LabZDjee/waeco-cool-power-m50u/lvd.pdf

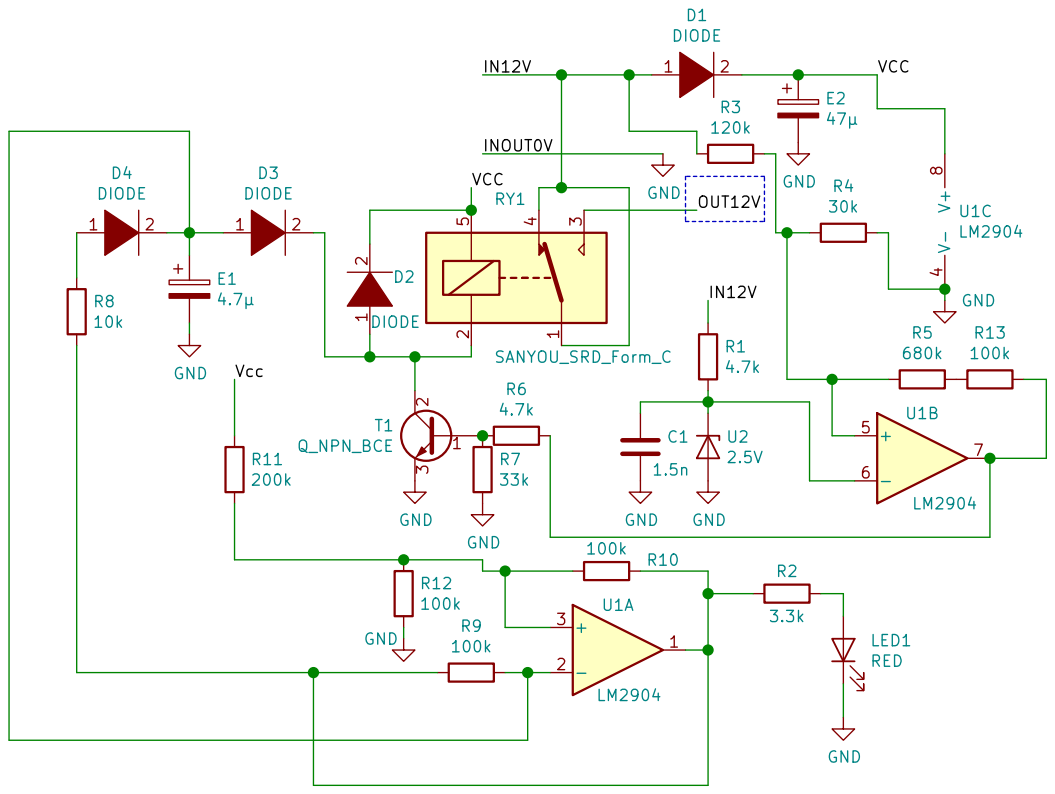
[picture p4: page 1]

cut-in 12.8V - cut-out 11.6 V
File: lvd.sch Sheet: / WAECO
