LabZDjee/waeco-cool-power-m50u/ltspice/led-flash.asc

D3: diode
D4: diode
E1: cap; 4.7µ
R8: res; 10k
R9: res; 100k
R10: res; 100k
R11: res; 200k
R12: res; 100k
U1: opamp2; LM2904
V1: voltage; 10V
Named nets: 0, LedDrive
.lib LM2904.cir
.tran 30
Period: 520 ms
Duty Cycle: 37 / 520 = 7%
If D3 connected, LED constantly on
