LabZDjee/waeco-cool-power-m50u/ltspice/compare.asc

D1: diode
R1: res; 470
R3: res; 120k
R4: res; 30k
R5: res; 350k
U1: opamp2; LM2904
V2: voltage; PWL(0 9 1 14 2 9)
VRef: voltage; 2.5V
Named nets: 0
.lib LM2904.cir
.tran 3
