LabZDjee/waeco-cool-power-m50u/lvd.sch

## KiCad design lvd.sch (2019-08-04)

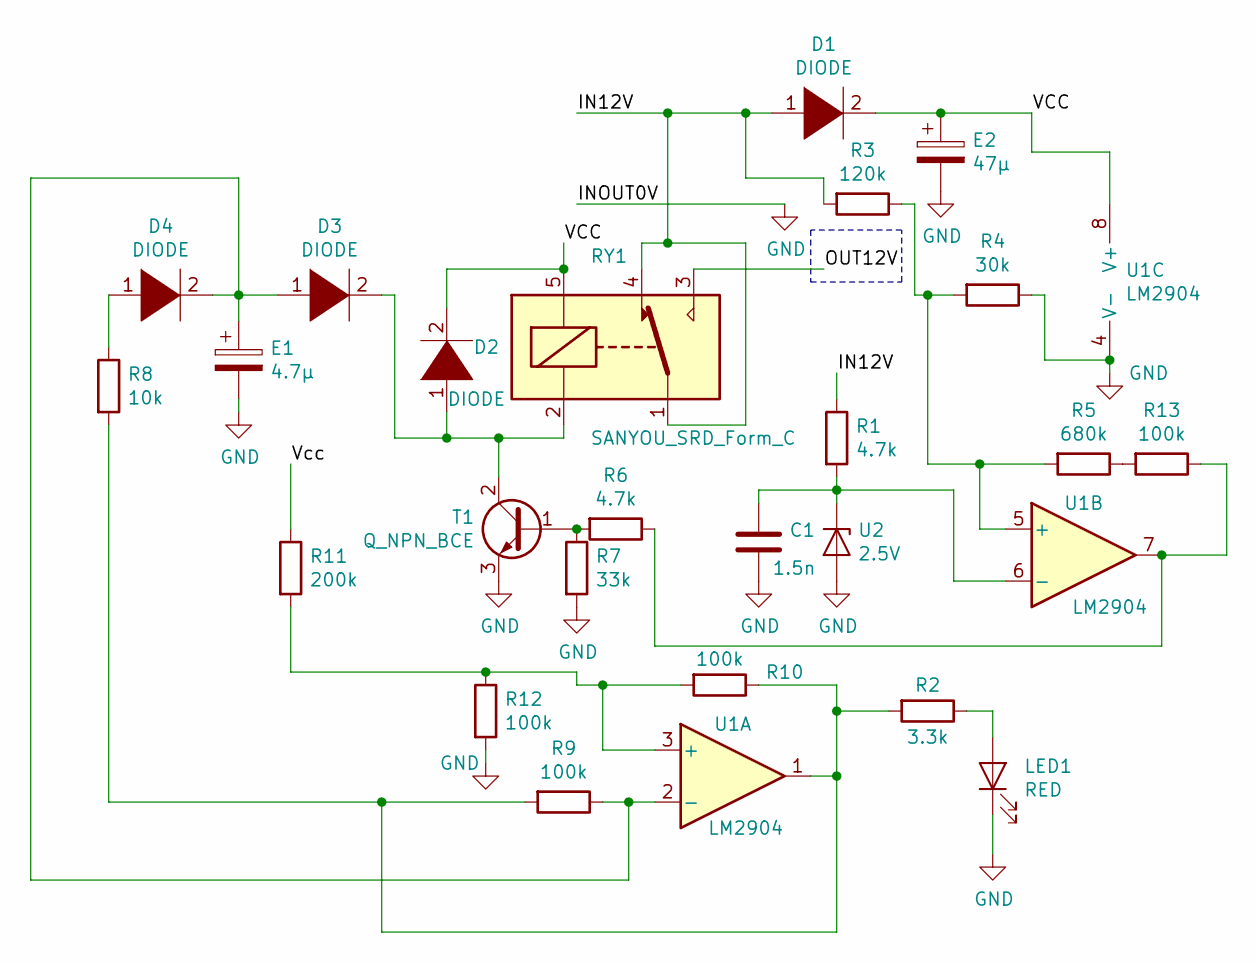
[picture p5: schematic lvd.sch]

Parts:
C1: 1.5n
D1, D2, D3, D4: DIODE
E1: 4.7µ
E2: 47µ
LED1: RED
R1, R6: 4.7k
R2: 3.3k
R3: 120k
R4: 30k
R5: 680k
R7: 33k
R8: 10k
R9, R10, R12, R13: 100k
R11: 200k
RY1: SANYOU_SRD_Form_C; Relay_SPDT_SANYOU_SRD_Series_Form_C
T1: Q_NPN_BCE
U1: LM2904
U2: 2.5V

Connections:
GND: C1.2, E1.2, E2.2, LED1.1 (K), R4.1, R7.2, R12.2, T1.3 (E), U1.4 (V-), U2.2 (A)
IN12V: D1.1 (K), R1.1, R3.2, RY1.1, RY1.4
unnamed: C1.1, R1.2, U1.6 (-), U2.1 (K)
unnamed: D2.1 (K), D3.2 (A), RY1.2, T1.2 (C)
unnamed: D3.1 (K), D4.2 (A), E1.1, R9.1, U1.2 (-)
unnamed: D4.1 (K), R8.1
unnamed: LED1.2 (A), R2.1
unnamed: R3.1, R4.2, R5.2, U1.5 (+)
unnamed: R6.2, R7.1, T1.1 (B)
unnamed: R2.2, R8.2, R9.2, R10.1, U1.1
unnamed: R10.2, R11.2, R12.1, U1.3 (+)
unnamed: R6.1, R13.1, U1.7
unnamed: R5.1, R13.2
OUT12V: RY1.3
Vcc: D1.2 (A), D2.2 (A), E2.1, R11.1, RY1.5, U1.8 (V+)
